charlesbaynham/GP22_RF_Photon_Correllation/PCB/BOM.xlsx

Refs | Value | Footprint | Quantity | MFR | MPN | SPR | SPN | Price Per component | Price Per board
R9;R7 | 100k | Resistors_SMD:R_0805_HandSoldering | 2 | - | - | - | - |  | 0
R8 | RS485_TERM | Resistors_ThroughHole:Resistor_Vertical_RM5mm | 1 | - | - | - | - |  | 0
R5;R6 | R | Resistors_SMD:R_0805_HandSoldering | 2 | - | - | - | - |  | 0
R38;R27;R26;R31;R30;R27;R26;R31;R30;R27;R26;R31;R30 | 10k | Resistors_SMD:R_0805_HandSoldering | 13 | - | - | - | - |  | 0
R35;R37 | 22R | Resistors_SMD:R_0805_HandSoldering | 2 | - | - | - | - |  | 0
R32;R33;R34;R29;R28;R29;R28;R29;R28 | 50R | Resistors_SMD:R_0805_HandSoldering | 9 | - | - | - | - |  | 0
R21;R22;R23;R3 | 100R | Resistors_SMD:R_0805_HandSoldering | 4 | - | - | - | - |  | 0
R20;R_Ser1;R_Ser2;R36 | 1k | Resistors_SMD:R_0805_HandSoldering | 4 | - | - | - | - |  | 0
R2;R1;R4 | 2M | Resistors_SMD:R_0805_HandSoldering | 3 | - | - | - | - |  | 0
C31;C29;C33;C34;C57;C24;C25;C26;C27;C20 | 100n | Capacitors_SMD:C_0805_HandSoldering | 10 | - | - | - | - |  | 0
C30;C32 | 8p | Capacitors_SMD:C_0805_HandSoldering | 2 | - | - | - | - |  | 0
C28;C4;C56;C18 | 1u | Capacitors_SMD:C_0805_HandSoldering | 4 | - | - | - | - |  | 0
C22 | 4u7 | Capacitors_SMD:C_0805_HandSoldering | 1 | - | - | - | - |  | 0
C21;C23 | 33u | Capacitors_SMD:C_0805_HandSoldering | 2 | - | - | - | - |  | 0
C19 | 10u | Capacitors_SMD:C_0805_HandSoldering | 1 | - | - | - | - |  | 0
C15;C16;C17 | 10p | Capacitors_SMD:C_0805_HandSoldering | 3 | - | - | - | - |  | 0
C12;C13;C14 | 10n | Capacitors_SMD:C_0805_HandSoldering | 3 | - | - | - | - |  | 0
C10;C11;C10;C11;C10;C11 | C_Small | Capacitors_SMD:C_0805_HandSoldering | 6 | - | - | - | - |  | 0
C1;C2;C5;C3 | C | Capacitors_SMD:C_0805_HandSoldering | 4 | - | - | - | - |  | 0
U2 | GP22 | Housings_DFN_QFN:QFN-32-1EP_5x5mm_Pitch0.5mm | 1 | ACAM | TDC-GP22 | Digikey | TDC-GP225KT&RCT-ND | 8.52 | 8.52
START1;STOP1;STOP2 | DP3T | Custom:ALPS_Rotary_SRBM | 3 | Apls Electric | SRBM131400 | RS | 123-9600 | 5.16 | 15.48
SCLK1;TX1;RX1;POWER1 | LED | LEDs:LED_0805 | 4 | Bivar | SM0805HC | RS | 174-9844 | 0.208 | 0.832
X1 | TSX-3225 X1E0000210013 | Crystals:crystal_FA238-TSX3225 | 1 | Epson | X1E000021001311 | RS | 667-6151 | 0.404 | 0.404
U12 | FT232RL | Housings_SSOP:SSOP-28_5.3x10.2mm_Pitch0.65mm | 1 | FTDI Chip | FT232RL | RS | 406-580 | 3.27 | 3.27
ICSP1 | HEADER | Pin_Headers:Pin_Header_Straight_2x03_Pitch2.54mm | 1 | Harwin | M20-9980346 | RS | 745-7046 | 0.2 | 0.2
U5 | IDT49FCT | Housings_SOIC:SOIC-20W_7.5x12.8mm_Pitch1.27mm | 1 | IDT | IDT49FCT3805ASOGI | RS | 715-4902 | 1.425 | 1.425
U3 | LTC6957-4 | Housings_SSOP:MSOP-12_3x4mm_Pitch0.65mm | 1 | Linear | LTC6957-4 | Digikey | LTC6957IMS-4#PBF-ND | 5.95 | 5.95
Y1 | 4MHz | Crystals:Crystal_HC49-4H_Vertical | 1 | Mercury | H49-4.000-18-30/50/4085 | RS | 672-0173 | 1.38 | 1.38
Y2 | 32.768 kHz | Crystals:Crystal_SMD_MicroCrystal_CC7V-T1A-2pin_3.2x1.5mm_HandSoldering | 1 | Micro Crystal | CM7V-T1A 32.768kHz 7pF +/-10ppm TA QC | RS | 729-3252 | 0.826 | 0.826
IC1 | ATMEGA328P-A | Housings_QFP:LQFP-32_7x7mm_Pitch0.8mm | 1 | Microchip Technology | ATMEGA328P-AN | RS | 131-0270 | 1.925 | 1.925
SineInput1;TTLInput1;STInput1;TTLOut1;TTLOut2;TTLOut3 | MMCX | Custom:MMCX_Socket | 6 | Molex | 73415-1001 | RS | 759-5300 | 3.97 | 23.82
P4 | USB_OTG | Custom:MICRO-B_USB_TOP_MOUNT | 1 | Molex | 47590-0001 | RS | 702-5481 | 0.502 | 0.502
U7 | MC74VHC1G04DTT1G | TO_SOT_Packages_SMD:SOT-353_SC-70-5_Handsoldering | 1 | ON Semiconductor | MC74VHC1G04DTT1G | RS | 806-3964 | 0.081 | 0.081
U1 | Right Angle | Backplane:96way_DIN_41612 | 1 | RS Pro | 252-210 | RS | 252-210 | 3.02 | 3.02
DISABLE_FLASH1;POWER_SEL1 | JMP | Pin_Headers:Pin_Header_Straight_1x03_Pitch2.54mm | 2 | RS Pro | 251-8092 | RS | 251-8092 | 0.093 | 0.186
U6 | LD1117S33TR | TO_SOT_Packages_SMD:SOT-223 | 1 | STMicroelectroncs | LD1117S33TR | RS | 168-6804 | 0.095 | 0.095
D7;D7;D7 | ESDA5V3SC6 | TO_SOT_Packages_SMD:SOT-23-5_HandSoldering | 3 | STMicroelectronics | ESDA5V3SC6 | RS | 250-000 | 0.357 | 1.071
CON1 | 5V power input | Connect:BARREL_JACK | 1 | Switchcraft | RAPC712X | Farnell | 1608726 | 1.56 | 1.56
FILT_SEL1;S+ DC/AC;S- DC/AC;S+ DC/AC;S- DC/AC;S+ DC/AC;S- DC/AC | HEADER | Pin_Headers:Pin_Header_Straight_2x02_Pitch2.54mm | 7 | TE Connectivity | 826632-2 | RS | 669-5288 | 0.335 | 2.345
U9 | SC74HC165N | Housings_DIP:DIP-16_W7.62mm_LongPads | 1 | TI | SN74HC165N | RS | 333-2978 | 0.308 | 0.308
U8 | SN74LV8154 | Housings_DIP:DIP-20_W7.62mm_LongPads | 1 | TI | SN74LV8154PW | RS | 663-2782 | 0.922 | 0.922
U4 | ISO3088 | Housings_SOIC:SOIC-16W_7.5x10.3mm_Pitch1.27mm | 1 | TI | ISO3088DW | RS | 121-9061 | 4.579 | 4.579
U11 | ISO7242 | Housings_SOIC:SOIC-16_7.5x10.3mm_Pitch1.27mm | 1 | TI | ISO7242CDW | RS | 121-9145 | 3.705 | 3.705
U10 | XC6206 | TO_SOT_Packages_SMD:SOT-23_Handsoldering | 1 | Torex | XC6206P332PR | Farnell | 8796998 | 0.483 | 0.483
 |  |  |  |  |  |  |  | Total component cost: | 82.889
 |  | Total component number: | 120 |  |  |  |  |  | 0
 |  | PCB Train Quotation (5 boards)
 |  | 5 day + 5 day
 |  | Manufacture | 312
 |  | Assembly | 920
 |  | Components | 83
 |  | Total | 1315
 |  | Total per board | 263
 |  | 10 day + 10 day
 |  | Manufacture | 231
 |  | Assembly | 613
 |  | Components | 83
 |  | Total | 927
 |  | Total per board | 185.4
