charlesbaynham/GP22_RF_Photon_Correllation/PCB/BOM_seanD_order.xlsx

Id | Refs | Number Required | Value | Footprint | Quantity per board | MFR | MPN | SPR | SPN | Customer Supplied? | Populate | Price Per component | Price Per board | For 8 boards | Ordered | Total | Received from Sean
1 | R9;R7 | 16 | 100k | Resistors_SMD:R_0805_HandSoldering | 2 | PCB Train free component stock | 0805-100K | - | - | FALSE | TRUE |  | £0.00 | 16 | 0 | £0.00 | FALSE
2 | R8 | 8 | - | Resistors_ThroughHole:Resistor_Vertical_RM5mm | 1 | - | - | - | - | FALSE | FALSE |  | £0.00 | 8 | 0 | £0.00 | FALSE
3 | R5 | 8 | 1M | Resistors_SMD:R_0805_HandSoldering | 1 | PCB Train free component stock | 0805-1M | - | - | FALSE | TRUE |  | £0.00 | 8 | 0 | £0.00 | FALSE
4 | R38;R27;R26;R31;R30;R27;R26;R31;R30;R27;R26;R31;R30 | 104 | 10k | Resistors_SMD:R_0805_HandSoldering | 13 | PCB Train free component stock | 0805-10K | - | - | FALSE | TRUE |  | £0.00 | 104 | 0 | £0.00 | FALSE
5 | R35;R37 | 16 | 22R | Resistors_SMD:R_0805_HandSoldering | 2 | PCB Train free component stock | 0805-22R | - | - | FALSE | TRUE |  | £0.00 | 16 | 0 | £0.00 | FALSE
6 | R32;R33;R34;R29;R28;R29;R28;R29;R28 | 72 | 50R | Resistors_SMD:R_0805_HandSoldering | 9 | PCB Train free component stock | 0805-51R | - | - | FALSE | TRUE |  | £0.00 | 72 | 0 | £0.00 | FALSE
7 | R21;R22;R23;R3 | 32 | 100R | Resistors_SMD:R_0805_HandSoldering | 4 | PCB Train free component stock | 0805-100R | - | - | FALSE | TRUE |  | £0.00 | 32 | 0 | £0.00 | FALSE
8 | R20;R_Ser1;R_Ser2;R36 | 32 | 1k | Resistors_SMD:R_0805_HandSoldering | 4 | PCB Train free component stock | 0805-1K | - | - | FALSE | TRUE |  | £0.00 | 32 | 0 | £0.00 | FALSE
9 | R2;R1;R4 | 24 | 2M | Resistors_SMD:R_0805_HandSoldering | 3 | PCB Train free component stock | 0805-2M | - | - | FALSE | TRUE |  | £0.00 | 24 | 0 | £0.00 | FALSE
10 | C31;C29;C33;C34;C57;C24;C25;C26;C27;C20 | 80 | 100n | Capacitors_SMD:C_0805_HandSoldering | 10 | PCB Train free component stock | 0805-100nF-50V | - | - | FALSE | TRUE |  | £0.00 | 80 | 0 | £0.00 | FALSE
11 | C30;C32 | 16 | 8p | Capacitors_SMD:C_0805_HandSoldering | 2 | AVX | 08055A8R2CAT2A | RS | 135-9011 | TRUE | TRUE | £0.07 | £0.14 | 16 | 100 | £7.20 | TRUE
12 | C28;C4;C56;C18 | 32 | 1u | Capacitors_SMD:C_0805_HandSoldering | 4 | PCB Train free component stock | 0805-1uF-50V | - | - | FALSE | TRUE |  | £0.00 | 32 | 0 | £0.00 | FALSE
13 | C22 | 8 | 4u7 | Capacitors_SMD:C_0805_HandSoldering | 1 | PCB Train free component stock | 0805-4.7uF-16V | - | - | FALSE | TRUE |  | £0.00 | 8 | 0 | £0.00 | FALSE
14 | C21;C23 | 16 | 33u | Capacitors_SMD:C_0805_HandSoldering | 2 | TDK | C2012X5R1A336M125AC | RS | 915-9274 | TRUE | TRUE | £0.96 | £1.91 | 16 | 20 | £19.12 | TRUE
15 | C19 | 8 | 10u | Capacitors_SMD:C_0805_HandSoldering | 1 | PCB Train free component stock | 0805-10uF-16V | - | - | FALSE | TRUE |  | £0.00 | 8 | 0 | £0.00 | FALSE
16 | C15;C16;C17 | 24 | x | Capacitors_SMD:C_0805_HandSoldering | 3 |  |  | - | - | FALSE | FALSE |  | £0.00 | 24 | 0 | £0.00 | FALSE
17 | C12;C13;C14 | 24 | 10n | Capacitors_SMD:C_0805_HandSoldering | 3 | PCB Train free component stock | 0805-10nF-50V | - | - | FALSE | TRUE |  | £0.00 | 24 | 0 | £0.00 | FALSE
18 | C6;C7;C8;C9;C10;C11 | 48 | 10n | Capacitors_SMD:C_0805_HandSoldering | 6 | PCB Train free component stock | 0805-10nF-50V | - | - | FALSE | TRUE |  | £0.00 | 48 | 0 | £0.00 | FALSE
19 | C1;C2;C5;C3 | 32 | 3.3p | Capacitors_SMD:C_0805_HandSoldering | 4 | PCB Train free component stock | 0805-3.3pF-50V | - | - | FALSE | TRUE |  | £0.00 | 32 | 0 | £0.00 | FALSE
20 | U2 | 8 | GP22 | Housings_DFN_QFN:QFN-32-1EP_5x5mm_Pitch0.5mm | 1 | ACAM | TDC-GP22 | Digikey | TDC-GP225KT&RCT-ND | TRUE | TRUE | £8.52 | £8.52 | 8 | 10 | £85.20 | TRUE
21 | START1;STOP1;STOP2 | 24 | DP3T | Custom:ALPS_Rotary_SRBM | 3 | Apls Electric | SRBM131400 | RS | 123-9600 | TRUE | TRUE | £5.16 | £15.48 | 24 | 24 | £123.84 | TRUE
22 | SCLK1;TX1;RX1;POWER1 | 32 | LED | LEDs:LED_0805 | 4 | Bivar | SM0805HC | RS | 174-9844 | TRUE | TRUE | £0.21 | £0.83 | 32 | 50 | £10.40 | TRUE
23 | X1 | 8 | TSX-3225 X1E0000210013 | Crystals:crystal_FA238-TSX3225 | 1 | Epson | X1E000021001311 | RS | 667-6151 | TRUE | TRUE | £0.40 | £0.40 | 8 | 10 | £4.04 | TRUE
24 | U12 | 8 | FT232RL | Housings_SSOP:SSOP-28_5.3x10.2mm_Pitch0.65mm | 1 | FTDI Chip | FT232RL | RS | 406-580 | TRUE | TRUE | £3.27 | £3.27 | 8 | 9 | £29.43 | TRUE
25 | ICSP1 | 8 | HEADER | Pin_Headers:Pin_Header_Straight_2x03_Pitch2.54mm | 1 | Harwin | M20-9980346 | RS | 745-7046 | TRUE | TRUE | £0.20 | £0.20 | 8 | 10 | £2.00 | TRUE
26 | U5 | 8 | IDT49FCT | Housings_SOIC:SOIC-20W_7.5x12.8mm_Pitch1.27mm | 1 | IDT | IDT49FCT3805ASOGI | RS | 715-4902 | TRUE | TRUE | £1.43 | £1.43 | 8 | 10 | £14.25 | TRUE
27 | U3 | 8 | LTC6957-4 | Housings_SSOP:MSOP-12_3x4mm_Pitch0.65mm | 1 | Linear | LTC6957-4 | Digikey | LTC6957IMS-4#PBF-ND | TRUE | TRUE | £5.95 | £5.95 | 8 | 10 | £59.50 | TRUE
28 | Y1 | 8 | 4MHz | Crystals:Crystal_HC49-4H_Vertical | 1 | Mercury | H49-4.000-18-30/50/4085 | RS | 672-0173 | TRUE | TRUE | £1.38 | £1.38 | 8 | 10 | £13.80 | TRUE
29 | Y2 | 8 | 32.768 kHz | Crystals:Crystal_SMD_MicroCrystal_CC7V-T1A-2pin_3.2x1.5mm_HandSoldering | 1 | Micro Crystal | CM7V-T1A 32.768kHz 7pF +/-10ppm TA QC | RS | 729-3252 | TRUE | TRUE | £0.83 | £0.83 | 8 | 10 | £8.26 | TRUE
30 | IC1 | 8 | ATMEGA328P-A | Housings_QFP:LQFP-32_7x7mm_Pitch0.8mm | 1 | Microchip Technology | ATMEGA328P-AN | RS | 131-0270 | TRUE | TRUE | £1.93 | £1.93 | 8 | 10 | £19.25 | TRUE
31 | SineInput1;TTLInput1;STInput1;TTLOut1;TTLOut2;TTLOut3 | 48 | MMCX | Custom:MMCX_Socket | 6 | Molex | 73415-1001 | RS | 759-5300 | TRUE | TRUE | £3.97 | £23.82 | 48 | 50 | £198.50 | TRUE
32 | P4 | 8 | USB_OTG | Custom:MICRO-B_USB_TOP_MOUNT | 1 | Molex | 47590-0001 | RS | 702-5481 | TRUE | TRUE | £0.50 | £0.50 | 8 | 10 | £5.02 | TRUE
33 | U7 | 8 | MC74VHC1G04DTT1G | TO_SOT_Packages_SMD:SOT-353_SC-70-5_Handsoldering | 1 | ON Semiconductor | MC74VHC1G04DTT1G | RS | 806-3964 | TRUE | TRUE | £0.08 | £0.08 | 8 | 100 | £8.10 | TRUE
34 | U1 | 8 | Right Angle | Backplane:96way_DIN_41612 | 1 | RS Pro | 252-210 | RS | 252-210 | TRUE | TRUE | £3.02 | £3.02 | 8 | 8 | £24.16 | TRUE
35 | DISABLE_FLASH1;POWER_SEL1 | 16 | JMP | Pin_Headers:Pin_Header_Straight_1x03_Pitch2.54mm | 2 | RS Pro | 251-8092 | RS | 251-8092 | TRUE | TRUE | £0.09 | £0.19 | 16 | 25 | £2.33 | TRUE
36 | U6 | 8 | LD1117S33TR | TO_SOT_Packages_SMD:SOT-223 | 1 | STMicroelectroncs | LD1117S33TR | RS | 714-0697 | TRUE | TRUE | £0.10 | £0.10 | 8 | 10 | £0.95 | TRUE
37 | D7;D7;D7 | 24 | ESDA5V3SC6 | TO_SOT_Packages_SMD:SOT-23-5_HandSoldering | 3 | STMicroelectronics | ESDA5V3SC6 | RS | 250-000 | TRUE | TRUE | £0.36 | £1.07 | 24 | 40 | £14.28 | TRUE
38 | CON1 | 8 | 5V power input | Connect:BARREL_JACK | 1 | Switchcraft | RAPC712X | Farnell | 1608726 | TRUE | TRUE | £1.56 | £1.56 | 8 | 10 | £15.60 | TRUE
39 | FILT_SEL1;S+ DC/AC;S- DC/AC;S+ DC/AC;S- DC/AC;S+ DC/AC;S- DC/AC | 56 | HEADER | Pin_Headers:Pin_Header_Straight_2x02_Pitch2.54mm | 7 | TE Connectivity | 826632-2 | RS | 669-5288 | TRUE | TRUE | £0.34 | £2.35 | 56 | 60 | £20.10 | TRUE
40 | U9 | 8 | SC74HC165N | Housings_DIP:DIP-16_W7.62mm_LongPads | 1 | TI | SN74HC165N | RS | 333-2978 | TRUE | TRUE | £0.31 | £0.31 | 8 | 25 | £7.70 | TRUE
41 | U8 | 8 | SN74LV8154 | Housings_DIP:DIP-20_W7.62mm_LongPads | 1 | TI | SN74LV8154PW | RS | 663-2782 | TRUE | TRUE | £0.92 | £0.92 | 8 | 10 | £9.22 | TRUE
42 | U4 | 8 | ISO3088 | Housings_SOIC:SOIC-16W_7.5x10.3mm_Pitch1.27mm | 1 | TI | ISO3088DW | RS | 660-7660 | TRUE | TRUE | £4.58 | £4.58 | 8 | 9 | £41.21 | TRUE
43 | U11 | 8 | ISO7242 | Housings_SOIC:SOIC-16_7.5x10.3mm_Pitch1.27mm | 1 | TI | ISO7242CDW | RS | 661-3447 | TRUE | TRUE | £3.71 | £3.71 | 8 | 9 | £33.34 | TRUE
44 | U10 | 8 | XC6206 | TO_SOT_Packages_SMD:SOT-23_Handsoldering | 1 | Torex | XC6206P332PR | Farnell | 8796998 | TRUE | TRUE | £0.48 | £0.48 | 8 | 10 | £4.83 | TRUE
45 | R6 | 8 | - | Resistors_SMD:R_0805_HandSoldering | 1 | - | - |  |  | FALSE | FALSE |  | £0.00 | 8 |  | £0.00 | FALSE
Total |  |  |  |  |  |  |  |  |  |  |  |  | £84.94 |  |  | £781.63 | 0
 |  |  | PCB Train Quotation (8 boards)
 |  |  | 5 day + 5 day
 |  |  | Manufacture | £419.15
 |  |  | Assembly | £1287.00
 |  |  | Components | £781.63
 |  |  | Total | £2487.78
 |  |  | Total per board | £310.97
 |  |  |  |  |  | 554
 |  |  |  |  |  | 419.15
