charlesbaynham/GP22_RF_Photon_Correllation/PCB/Rack mounting/GP22_Panel_HP14.SLDPRT

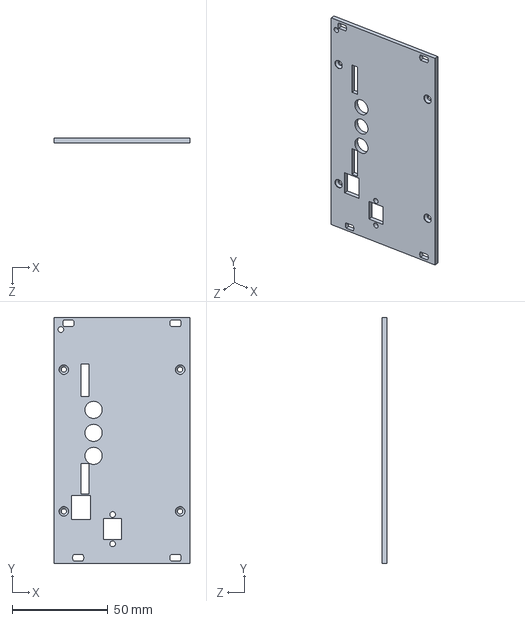
[picture p1: CAD file, 2019-10-17]
PCB/Rack mounting/GP22_Panel_HP14.SLDPRT
70.8 x 128.4 x 2.50 mm
