charlesbaynham/GP22_RF_Photon_Correllation/PCB/Rack mounting/GP22_Panel_HP12.STL

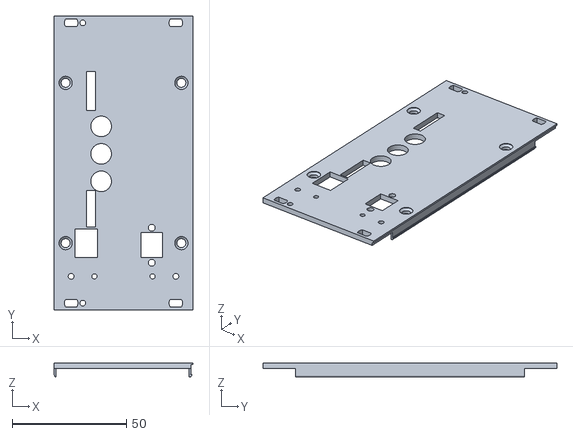
[picture p2: CAD file, 2019-10-17]
PCB/Rack mounting/GP22_Panel_HP12.STL
60.6 x 128.4 x 6.20
