charlesbaynham/GP22_RF_Photon_Correllation/(list of files, cad)

Other CAD files:
PCB/Rack mounting/GP22_Panel_HP14.STL
