charlesbaynham/GP22_RF_Photon_Correllation/PCB/GP22_board.kicad_pcb

## KiCad design PCB/GP22_board.kicad_pcb (2018-09-26)

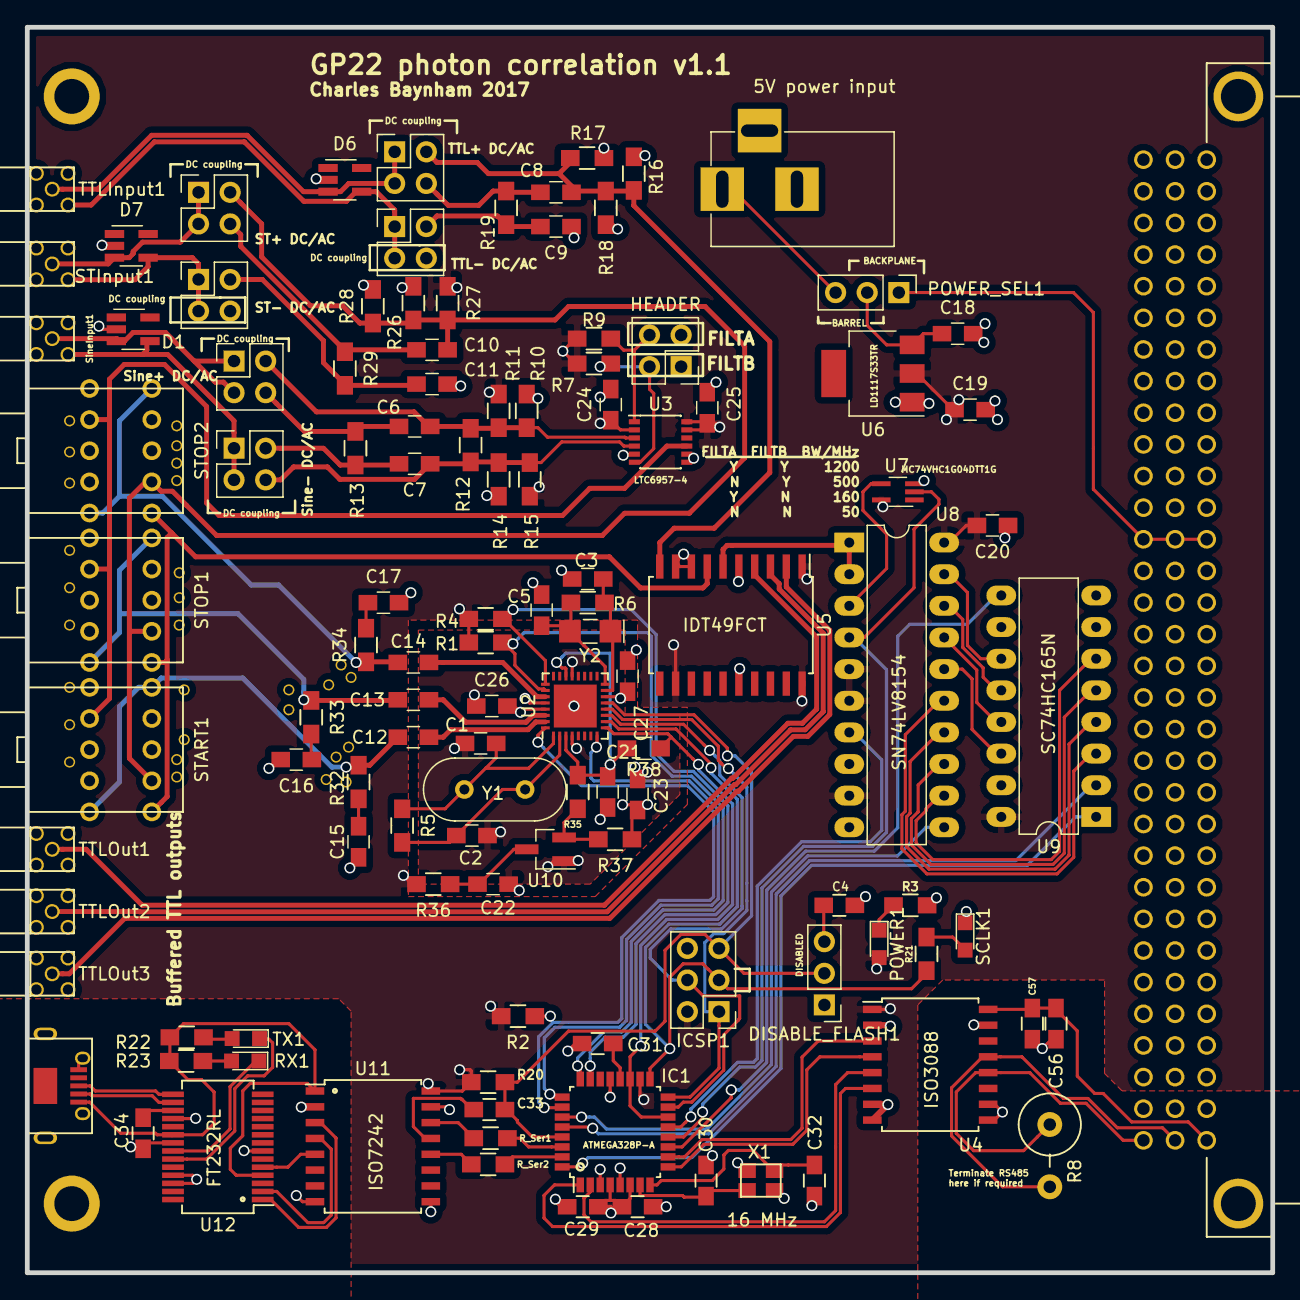
[picture p11: board GP22_board.kicad_pcb from above]

Board: 4 copper layers, 100.0 x 100.0 mm, 145 parts (0 on the bottom side), 108 nets.

Parts:
C1, C2, C3, C5: 3p3; C_0805_HandSoldering
C4, C18, C28, C56: 1u; C_0805_HandSoldering
C6, C7, C8, C9, C10, C11: C_Small; C_0805_HandSoldering
C12, C13, C14: 10n; C_0805_HandSoldering
C15, C16, C17: x; C_0805_HandSoldering
C19: 10u; C_0805_HandSoldering
C20, C24, C25, C26, C27, C29, C31, C33, C34, C57: 100n; C_0805_HandSoldering
C21, C23: 33u; C_0805_HandSoldering
C22: 4u7; C_0805_HandSoldering
C30, C32: 8p; C_0805_HandSoldering
CON1: 5V power input; BARREL_JACK
D1, D6, D7: ESDA5V3SC6; SOT-23-5_HandSoldering
DISABLE_FLASH1: JMP; Pin_Header_Straight_1x03_Pitch2.54mm
FILT_SEL1: HEADER; Pin_Header_Straight_2x02_Pitch2.54mm
IC1: ATMEGA328P-A; LQFP-32_7x7mm_Pitch0.8mm
ICSP1: HEADER; Pin_Header_Straight_2x03_Pitch2.54mm
P4: USB_OTG; MICRO-B_USB_TOP_MOUNT
P7, P8, P9, P10, P11, P12: HEADER; Pin_Header_Straight_2x02_Pitch2.54mm
POWER1: LED; LED_0805
POWER_SEL1: JMP; Pin_Header_Straight_1x03_Pitch2.54mm
R1, R2, R4: 2M; R_0805_HandSoldering
R3, R21, R22, R23: 100R; R_0805_HandSoldering
R5: 1M; R_0805_HandSoldering
R6: x; R_0805_HandSoldering
R7, R9: 100k; R_0805_HandSoldering
R8: RS485_TERM; Resistor_Vertical_RM5mm
R10, R11, R14, R15, R16, R17, R26, R27, R38: 10k; R_0805_HandSoldering
R12, R13, R18, R19, R28, R29, R32, R33, R34: 50R; R_0805_HandSoldering
R20, R36: 1k; R_0805_HandSoldering
R35, R37: 22R; R_0805_HandSoldering
RX1: LED; LED_0805
R_Ser1, R_Ser2: 1k; R_0805_HandSoldering
SCLK1: LED; LED_0805
START1: DP3T; ALPS_Rotary_SRBM
STInput1: MMCX; MMCX_Socket
STOP1, STOP2: DP3T; ALPS_Rotary_SRBM
SineInput1: MMCX; MMCX_Socket
TTLInput1: MMCX; MMCX_Socket
TTLOut1, TTLOut2, TTLOut3: MMCX; MMCX_Socket
TX1: LED; LED_0805
U1: Right Angle; 96way_DIN_41612
U2: GP22; QFN-32-1EP_5x5mm_Pitch0.5mm
U3: LTC6957-4; MSOP-12_3x4mm_Pitch0.65mm
U4: ISO3088; SOIC-16W_7.5x10.3mm_Pitch1.27mm
U5: IDT49FCT; SOIC-20W_7.5x12.8mm_Pitch1.27mm
U6: LD1117S33TR; SOT-223
U7: MC74VHC1G04DTT1G; SOT-353_SC-70-5_Handsoldering
U8: SN74LV8154; DIP-20_W7.62mm_LongPads
U9: SC74HC165N; DIP-16_W7.62mm_LongPads
U10: XC6206; SOT-23_Handsoldering
U11: ISO7242; SOIC-16_7.5x10.3mm_Pitch1.27mm
U12: FT232RL; SSOP-28_5.3x10.2mm_Pitch0.65mm
VIA**: ViaHack
VIA**#2, VIA**#3, VIA**#4, VIA**#5, VIA**#6, VIA**#7, VIA**#8, VIA**#9, VIA**#10, VIA**#11, VIA**#12, VIA**#13, VIA**#14, VIA**#15, VIA**#16, VIA**#17, VIA**#18, VIA**#19, VIA**#20, VIA**#21, VIA**#22, VIA**#23, VIA**#24, VIA**#25, VIA**#26, VIA**#27, VIA**#28, VIA**#29: ViaHack
X1: TSX-3225 X1E0000210013; crystal_FA238-TSX3225
Y1: 4MHz; Crystal_HC49-4H_Vertical
Y2: 32.768 kHz; Crystal_SMD_MicroCrystal_CC7V-T1A-2pin_3.2x1.5mm_HandSolder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

Connections:
+3V3: C19.1, C20.2, C24.1, C25.1, C28.1, C29.1, IC1.4, IC1.6, IC1.18, ICSP1.2, POWER1.2, R1.1, R2.2, R4.1, R7.2, R9.1, R11.1, R15.2, R17.1, R20.1, R27.1, R36.2, U3.2, U3.11, U3.12, U4.1, U5.1, U5.12, U5.20, U6.2, U7.5, U8.5, U8.6, U8.9, U8.20, U9.16, U11.16
/ARD_RST: C33.1, DISABLE_FLASH1.2, IC1.29, ICSP1.5, R20.2, U2.13
/BPSubsheet/+3.3V: U1.A15, U1.B15, U1.C15
/BPSubsheet/+12V: U1.A9, U1.B9, U1.C9
/BPSubsheet/+15V: U1.A5, U1.B5, U1.C5
/BPSubsheet/+24V: U1.A1, U1.B1, U1.C1
/BPSubsheet/-5V: U1.A11, U1.B11, U1.C11
/BPSubsheet/-12V: U1.A7, U1.B7, U1.C7
/BPSubsheet/-15V: U1.A3, U1.B3, U1.C3
/Backplane_5V: POWER_SEL1.1, U1.A13, U1.B13, U1.C13
/CTR_BIT_SEL: IC1.12, U7.2, U8.4
/CTR_LOAD: IC1.13, U8.7
/Counter/~CTR_GAL: U7.4, U8.3
/DIYino/D0/RX: IC1.30, R_Ser1.1
/DIYino/D1/TX: IC1.31, R_Ser2.2
/DIYino/RX: R_Ser1.2, U11.14
/DIYino/TX: R_Ser2.1, U11.12
/DIYino/USB_3V3: C34.1, U12.17
/DIYino/USB_5V: P4.1, R22.2, R23.2, U11.1, U12.4, U12.20
/DIYino/USB_D+: P4.3, U12.15
/DIYino/USB_D-: P4.2, U12.16
/DIYino/USB_GND: C34.2, P4.5, P4.6, U11.2, U11.8, U12.7, U12.18, U12.21, U12.25, U12.26
/DIYino/USB_RESET_IN: U11.4, U12.2
/DIYino/USB_RESET_OUT: C33.2, U11.13
/G1: C12.2, U2.31
/G2: C13.2, U2.30
/G3: C14.2, U2.27
/GP22_CS: IC1.14, IC1.19, R38.1, U2.9
/GP22_EN_START: IC1.26, R2.1, U2.32
/GP22_EN_STOP1: IC1.24, R1.2, U2.26
/GP22_EN_STOP2: IC1.23, R4.2, U2.25
/GP22_INT: IC1.25, U2.8
/GP22_MISO: IC1.16, ICSP1.1, U2.12
/GP22_MOSI: IC1.15, ICSP1.4, U2.11
/GP22_SCK: IC1.17, ICSP1.3, R21.1, U2.10
/GP22_START: C12.1, R32.1, START1.1a, START1.5b
/GP22_STOP1: C13.1, R33.1, STOP1.1a, STOP1.5b
/GP22_STOP2: C14.1, R34.1, STOP2.1a, STOP2.5b
/GP22_VCC: C23.1, C26.2, C27.2, R37.1, U2.14, U2.29
/GP22_VIO: C21.1, R35.1, R38.2, U2.3, U2.22
/InputCoupling2/InputGnd: D6.4, P10.1, P10.3, TTLInput1.2
/InputCoupling2/InputSignal: D6.3, P9.1, P9.3, TTLInput1.1
/InputCoupling2/OutputS+: C8.2, P9.2, R16.1, R17.2, R18.1, U5.10
/InputCoupling2/RF_2: C8.1, P9.4, R19.1
/InputCoupling2/RF_4: C9.2, P10.2, R19.2
/InputCoupling3/InputGnd: D7.4, P12.1, P12.3, STInput1.2
/InputCoupling3/InputSignal: D7.3, P11.1, P11.3, STInput1.1
/InputCoupling3/RF_2: C10.1, P11.4, R29.1
/InputCoupling3/RF_4: C11.2, P12.2, R29.2
/InputCoupling/InputGnd: D1.4, P8.1, P8.3, SineInput1.2
/InputCoupling/InputSignal: D1.3, P7.1, P7.3, SineInput1.1
/InputCoupling/OutputS+: C6.2, P7.2, R10.1, R11.2, R12.1, U3.3
/InputCoupling/OutputS-: C7.1, P8.4, R12.2, R14.2, R15.1, U3.4
/InputCoupling/RF_2: C6.1, P7.4, R13.1
/InputCoupling/RF_4: C7.2, P8.2, R13.2
/REG_CLK: IC1.28, U9.2
/REG_DATA: IC1.11, U9.9
/REG_LOAD: IC1.32, U9.1
/RS485_+5V: C56.1, C57.1, U1.C32, U4.16
/RS485_A: R8.1, U1.A32, U4.12
/RS485_B: R8.2, U1.B32, U4.13
/RS485_D: IC1.1, U4.6
/RS485_DE: IC1.2, U4.5
/RS485_GND: C56.2, C57.2, U1.A31, U1.B31, U1.C31, U4.9, U4.10, U4.15
/RS485_R: IC1.10, U4.3
/RS485_RE: IC1.9, U4.4
/SineRectified: START1.4a, STOP1.4a, STOP2.4a, U3.9
/StraightThrough: C10.2, P11.2, R26.1, R27.2, R28.1, START1.2b, STOP1.2b, STOP2.2b
/TTLBuffered: START1.1b, STOP1.1b, STOP2.1b, U5.7
/TTLBufferedOut1: TTLOut1.1, U5.4
/TTLBufferedOut2: TTLOut2.1, U5.3
/TTLBufferedOut3: TTLOut3.1, U5.2
/TTLBufferedOut_toCounter: U5.6, U8.1, U8.2
/~CTR_CLR: IC1.27, U8.11
GND: C1.1, C2.1, C3.2, C4.2, C5.2, C9.1, C11.1, C15.2, C16.2, C17.2, C18.2, C19.2, C20.1, C21.2, C22.2, C23.2, C24.2, C25.2, C26.1, C27.1, C28.2, C29.2, C30.1, C31.2, C32.2, CON1.2, CON1.3, D1.2, D6.2, D7.2, FILT_SEL1.1, FILT_SEL1.3, IC1.3, IC1.5, IC1.21, ICSP1.6, P10.4, P12.4, R3.2, R10.2, R14.1, R16.2, R18.2, R26.2, R28.2, SCLK1.1, TTLOut1.2, TTLOut2.2, TTLOut3.2, U1.A2, U1.A4, U1.A6, U1.A8, U1.A10, U1.A12, U1.A14, U1.A16, U1.B2, U1.B4, U1.B6, U1.B8, U1.B10, U1.B12, U1.B14, U1.B16, U1.C2, U1.C4, U1.C6, U1.C8, U1.C10, U1.C12, U1.C14, U1.C16, U2.4, U2.21, U2.28, U2.33, U3.5, U3.7, U3.8, U4.2, U4.7, U4.8, U5.5, U5.8, U5.9, U5.16, U6.1, U7.3, U8.10, U9.8, U9.10, U9.15, U10.1, U11.9, U11.15, VIA**.1, VIA**#2.1, VIA**#3.1, VIA**#4.1, VIA**#5.1, VIA**#6.1, VIA**#7.1, VIA**#8.1, VIA**#9.1, VIA**#10.1, VIA**#11.1, VIA**#12.1, VIA**#13.1, VIA**#14.1, VIA**#15.1, VIA**#16.1, VIA**#17.1, VIA**#18.1, VIA**#19.1, VIA**#20.1, VIA**#21.1, VIA**#22.1, VIA**#23.1, VIA**#24.1, VIA**#25.1, VIA**#26.1, VIA**#27.1, VIA**#28.1, VIA**#29.1, X1.3
unnamed: C1.2, R5.1, U2.1, Y1.2
unnamed: C2.2, R5.2, U2.2, Y1.1
unnamed: C3.1, R6.2, U2.15, Y2.1
unnamed: C4.1, DISABLE_FLASH1.3
unnamed: C5.1, R6.1, U2.16, Y2.2
unnamed: C15.1, R32.2
unnamed: C16.1, R33.2
unnamed: C17.1, R34.2
unnamed: C18.1, POWER_SEL1.2, U6.3
unnamed: C22.1, R36.1, U10.3
unnamed: C30.2, IC1.7, X1.1
unnamed: C31.1, IC1.20
unnamed: C32.1, IC1.8, X1.2
unnamed: CON1.1, POWER_SEL1.3
unnamed: FILT_SEL1.2, R7.1, U3.6
unnamed: FILT_SEL1.4, R9.2, U3.1
unnamed: POWER1.1, R3.1
unnamed: R21.2, SCLK1.2
unnamed: R22.1, TX1.2
unnamed: R23.1, RX1.2
unnamed: R35.2, R37.2, U10.2
unnamed: RX1.1, U12.22
unnamed: TX1.1, U12.23
unnamed: U8.12, U9.6
unnamed: U8.13, U9.5
unnamed: U8.14, U9.4
unnamed: U8.15, U9.3
unnamed: U8.16, U9.14
unnamed: U8.17, U9.13
unnamed: U8.18, U9.12
unnamed: U8.19, U9.11
unnamed: U11.3, U12.1
unnamed: U11.5, U12.5
