charlesbaynham/GP22_RF_Photon_Correllation/TDC_Arduino_Driver/CommandHandler/examples/BasicUsage/BasicUsage.ino

#include <CommandHandler.h>

// Create a CommandHandler object to hold 5 commands
CommandHandler<5> h;


///////////////////////////////////////////////////////
// Declare functions to be called by serial commands //
///////////////////////////////////////////////////////

commandFunction helloWorld; // "hello"
commandFunction helloWorldQ; // "hello?"
commandFunction echoMe; // "echo"
commandFunction adder; // "add"
commandFunction echoMany; // "echoMany"

///////////////////////////////////////////////////////
//             End function declaration              //
///////////////////////////////////////////////////////


void setup() {

  Serial.begin(57600);
  Serial.println(F("Program started..."));

	// Register serial commands for triggering the previously
	// declared functions

	// Commands are case insensitive. Here we choose a serial command, the number of
	// parameters it takes (to be read as strings, delimited by spaces) and the
	// function it links to

	h.registerCommand(COMMANDHANDLER_HASH( "heLLo" ), 0, helloWorld);
	h.registerCommand(COMMANDHANDLER_HASH( "hello?"), 0, helloWorldQ);
	h.registerCommand(COMMANDHANDLER_HASH( "eCHo"), 1, echoMe);
	h.registerCommand(COMMANDHANDLER_HASH( "add"), 2, adder);

	// Setting num params to "-1" will allow any number of params to be passed
	h.registerCommand(COMMANDHANDLER_HASH( "echoMany"), -1, echoMany);
}

void loop() {

	// Check for commands
	if (h.commandWaiting()) {

		// Execute first waiting command
		CommandHandlerReturn result = h.executeCommand();

		// Report any errors
		switch (result) {
		case CommandHandlerReturn::COMMAND_NOT_FOUND:

			Serial.println(F("Command not found"));
			break;

		case CommandHandlerReturn::WRONG_NUM_OF_PARAMS:

			Serial.println(F("Wrong number of params"));
			break;

		default:

			Serial.print(F("Error code "));
			Serial.println(int(result));

		}
	}

	// Check for serial input
	while (Serial.available()) {
		// Queue input for processing
		h.addCommandChar(Serial.read());
	}
}

///////////////////////////////////////////////////////
//                 Define functions                  //
///////////////////////////////////////////////////////

// Takes no params
void helloWorld(const ParameterLookup& params) {

	Serial.println(F("Hello world!"));

}

// Takes no params
void helloWorldQ(const ParameterLookup& params) {

	Serial.println(F("You sent a SCPI query"));
}

// Echo a string
// 1 param
void echoMe(const ParameterLookup& params) {

	Serial.print(F("Passed string was: \""));
	Serial.print(params[1]);
	Serial.print(F("\", command was: "));
	Serial.println(params[0]);
}

// Add two numbers
// 2 params
void adder(const ParameterLookup& params) {

	// Convert the first parameter to a number
	double first = atof(params[1]);

	// And the second
	double second = atof(params[2]);

	// Add and output
	Serial.print(F("Sum of "));
	Serial.print(first);
	Serial.print(F(" and "));
	Serial.print(second);
	Serial.print(F(" is "));
	Serial.println(first + second);
}

// Echo unlimited number of parameters
// unlimited paramas
void echoMany(const ParameterLookup& params) {

	Serial.print(F("Number of params to echo is: "));
	Serial.println(params.size());

	// Loop until list is done
	for (int i = 0; i < params.size(); i++) {
		Serial.print('"');
		Serial.print(params[i]);
		Serial.println('"');
	}
}
