charlesbaynham/GP22_RF_Photon_Correllation/TDC_Arduino_Driver/latest_hash.h

/* This file is automatically overwritten by git 
 * whenever a commit or checkout is completed. 
 * 
 * If you can see this comment, you must copy the files "post-checkout"
 * and "post-commit" into the .git/hooks folder */

#define LATEST_HASH "???????"
