charlesbaynham/GP22_RF_Photon_Correllation/(commit log)

2015-02-25 Rewrite into driver
2015-02-26 README. Add note to ensure that DELVAL1 is set to zero before you attempt measurements, thus avoiding many hours of debugging
    [TDC_Arduino_Driver.ino]
2015-02-26 Do EEPROM load in the arduino init rather than before each measurement
2015-03-12 Calibration routine for measurement mode 1
2015-03-12 Clarify the output of the calibration routine
2015-03-13 Add Calibrate method and prepare for split metweeb measurement mode 1 & 2
2015-03-13 Make arduino aware of which mode it's in and report data accordingly (16 bits or 32 bits depending on calibration settings)
2015-03-13 Arduino report timeouts properly in non-calibrated mode
2015-03-13 Labview interface to setup defaults, read uncalibrated data and test for the calibration wobble
2015-03-16 More informative errors and comments
    [TDC_Arduino_Driver.ino]
2015-03-16 Use the ACAM sequence for calibration but read the pointer from STATUS N.B. These calibration measurements seem to loop very predictably. I think this is the TDC, not my code
2015-03-16 Check status before reading calibration
2015-03-16 Go into MM2 and use quad resolution for the calibration
2015-03-16 Labview stuff: Default mode is now double resolution, measurements take account of this. Calibration is done in quad mode and stored for single mode.
2015-03-17 Move the init for calibration to before the calculation requests since the START_TDC_CAL actually produces hits. Also update Labview to reflect corrected calibration.
    [TDC_Arduino_Driver.ino]
2015-03-17 Fix odd ordering of calibration in single measurement
2015-03-20 Store all registers on the arduino
2015-03-20 Add function for high speed clock calibration
2015-03-20 Labview: High freq calibration method
2015-03-20 Integrate calibrated clock into all VIs
2015-03-20 Calibrate the HF clock on startup
2015-03-20 Add calibration to the state machine
2015-03-20 Add configuration options for double precision / auto-calibrate
2015-03-31 Adapt for new breakout board
2015-05-07 Add VI to return multiple measurements, taking care of calibration itself
2016-05-13 Basic MWE of error
    [TDC_Arduino_Driver.ino]
2016-05-23 Fix memory leak
    Fix memory leak, check for too long commands better. Also improve
    debugging by adding macros and more useful messages
    [CommandHandler.h]
2016-05-23 Found and fixed the problem!
    [TDC_Arduino_Driver.ino]
2016-05-23 STILL a mem leak!
    [TDC_Arduino_Driver.ino]
2016-05-23 Found a really silly mem leak
    [TDC_Arduino_Driver.ino]
2016-05-24 Avoid copying Lists by using const references where possible
    [TDC_Arduino_Driver.ino]
2016-07-01 Correctly detect start and end of commands
    [CommandHandler.h]
2016-07-05 Structure for new stack based commandHandler (not working yet)
    [CommandHandler.h]
2016-07-05 Fix newly broken EEPROM functionality
    [CommandHandler.h]
2016-07-07 BUG: Check for Serial comms before outputting
    [CommandHandler.h]
2016-07-11 Bug in setting registers
    [TDC_Arduino_Driver.ino]
2016-07-13 Set default TDC settings to ACAM's settings from their VI. Update Labview to use new commands.
    These settings produce output, but the conversion is wrong: we're assuming LSBs but actually reading converted floats
    [TDC_Arduino_Driver.ino]
2016-07-28 BUGFIX: ssending register settings failed if the first bit was high
    [TDC_Arduino_Driver.ino]
2016-10-21 Be a bit less memory hungry:
    Avoid Strings and don't request MAX_COMMAND_SIZE buffers from the stack other than the preassigned one
    [CommandHandler.h]
2016-11-03 Fix annoying typecasting problem
    [GP22_reg.h]
2017-01-31 NPL Backplane template initial commit
    [BPSubsheet.sch, DIYino.sch, GP22_board.kicad_pcb, GP22_board.sch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]
2017-01-31 Add GP22 schematic
2017-02-03 Add components to library
    [BPSubsheet.sch, DIYino.sch, GP22_board.sch]
2017-02-03 Inputs designed
    [BPSubsheet.sch, DIYino.sch, GP22_board.sch, InputCoupling.sch]
2017-02-09 Nearly finish schematic, add counter, coupling options
    [BPSubsheet.sch, Counter.sch, DIYino.sch, GP22_board.sch, InputCoupling.sch, SignalSelection.sch]
2017-02-09 Complete (?) schematic, footprints and component selection
    [BPSubsheet.sch, Counter.sch, DIYino.sch, GP22_Power.sch, GP22_board.sch, InputCoupling.sch, SignalSelection.sch]
2017-02-09 Use MCXX sockets instead of SMA because otherwise it won't all fit!
    [GP22_board.sch, InputCoupling.sch]
2017-02-09 Route the signals! And replace the diodes
    [BPSubsheet.sch, Counter.sch, DIYino.sch, GP22_Power.sch, GP22_board.sch, InputCoupling.sch, SignalSelection.sch]
2017-02-09 Board nearly done
    [Counter.sch, GP22_Power.sch, GP22_board.kicad_pcb, GP22_board.sch, InputCoupling.sch, SignalSelection.sch]
2017-02-10 Take 5V from backplane instead of 3V3: regulate it on-board
    [BPSubsheet.sch, Counter.sch, DIYino.sch, GP22_Power.sch, GP22_board.sch, InputCoupling.sch, SignalSelection.sch]
2017-02-10 DRC passes
    [BPSubsheet.sch, Counter.sch, DIYino.sch, GP22_Power.sch, GP22_board.kicad_pcb, GP22_board.sch, InputCoupling.sch, SignalSelection.sch]
2017-02-10 Silkscreen labelling
    [GP22_board.kicad_pcb, InputCoupling.sch]
2017-02-10 Tweaks to RF path
    [BPSubsheet.sch, Counter.sch, DIYino.sch, GP22_Power.sch, GP22_board.kicad_pcb, GP22_board.sch, InputCoupling.sch, SignalSelection.sch]
2017-02-10 Flood the top and bottom
    [GP22_board.kicad_pcb]
2017-02-10 Swap plane order and route power by bottom pour, for EMC and ground-inductance considerations
    [GP22_board.kicad_pcb, GP22_board.sch]
2017-02-10 Add soldermask to via hack, label board, gerbers
    [GP22_board-B.Cu.gbl, GP22_board-B.Mask.gbs, GP22_board-B.Paste.gbp, GP22_board-B.SilkS.gbo, GP22_board-Edge.Cuts.gm1, GP22_board-F.Cu.gtl, GP22_board-F.Mask.gts, GP22_board-F.Paste.gtp]
2017-02-20 BOM added
    [BOM.xlsx]
2017-03-01 Timeout warning for calibration
2017-03-01 Bug fix: CS for TDC was floating to undefined level when MC was not flashed, causing SPI pollution
    Added a 10k pullup resistor to CS to fix this
    [GP22_board-B.Cu.gbl, GP22_board-B.Mask.gbs, GP22_board-B.Paste.gbp, GP22_board-B.SilkS.gbo, GP22_board-Edge.Cuts.gm1, GP22_board-F.Cu.gtl, GP22_board-F.Mask.gts, GP22_board-F.Paste.gtp]
2017-03-13 Add Solidworks frontpanel
    [Panel-recognised.SLDPRT]
2017-03-13 Save changes to panel and output as STL
    [GP22_Panel.SLDPRT, GP22_Panel.STL]
2017-03-13 Remove old named panel
    [Panel-recognised.SLDPRT]
2017-03-21 Correct stack overflow error and report command_roo_long errors
    [CommandHandler.h]
2017-07-20 Speed up SPI comms
2017-07-20 Multiple measurement mode listens to calibration, device starts at defaults + double res, mode 1
2018-06-28 Update sch for new kicad version
    [BPSubsheet.sch, Counter.sch, DIYino.sch, GP22_Power.sch, GP22_board.sch, InputCoupling.sch]
2018-06-28 Ground crystal case
    [Counter.sch, DIYino.sch]
2018-06-28 Correct input coupling orientation
    [BPSubsheet.sch, Counter.sch, DIYino.sch, GP22_Power.sch, InputCoupling.sch]
2018-06-28 Correct pin headers to odd-even
    [DIYino.sch, GP22_board.sch, InputCoupling.sch]
2018-06-28 Record the part number of the rotary switch
2018-06-28 Fix the Rotary switch schematic file
    [GP22_board.sch]
2018-06-28 Create netlist and update board: no changes except to crystal grounding
    [GP22_board.kicad_pcb]
2018-08-08 Fix Rotary switch footprint (NEVER TRUST KICAD FOOTPRINTS!!!)
    [GP22_board.kicad_pcb]
2018-08-08 Produce BOM with "Boms away"
    [BOM.csv, BOM.xlsx, BPSubsheet.sch, Counter.sch, DIYino.sch, GP22_Power.sch, GP22_board.kicad_pcb, GP22_board.sch]
2018-08-08 Labelling tweaks
    [GP22_board.kicad_pcb]
2018-08-08 Output gerbers
    [BOM.csv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]
2018-08-09 BOM corrections (thanks Sean!)
    [BOM.xlsx, DIYino.sch, GP22_board.sch, InputCoupling.sch]
2018-08-14 Remove redundant trace spottted by Newbury
    [GP22_board-B.Cu.gbl, GP22_board-B.Mask.gbs, GP22_board-B.Paste.gbp, GP22_board-B.SilkS.gbo, GP22_board-Edge.Cuts.gm1, GP22_board-F.Cu.gtl, GP22_board-F.Mask.gts, GP22_board-F.Paste.gtp]
2018-09-10 Print schematic
    [BPSubsheet.sch, Counter.sch, DIYino.sch, GP22_Power.sch, GP22_board.sch, InputCoupling.sch]
2018-09-20 Get final cap values for BOM order with PCBTrain
    [BOM_seanD_order.xlsx, GP22_board.kicad_pcb, GP22_board.sch, InputCoupling.sch]
2018-09-26 Correct BOM issues in schematic + update to Kicad v5.0
    [BPSubsheet-2018-09-26-16-41-27.sch, Counter-2018-09-26-16-41-27.sch, DIYino-2018-09-26-16-41-27.sch, GP22_Power-2018-09-26-16-41-27.sch, GP22_board-2018-09-26-16-41-27.sch, InputCoupling-2018-09-26-16-41-27.sch]
2018-09-26 Update board to Kicad v5 (no changes yet)
    [GP22_board.kicad_pcb]
2018-10-05 Correct logic bug in calibration routine and remove unused (and impossible) method
    [TDC_Arduino_Driver.ino]
2019-10-08 Defaults for measure()
    [BOM.xlsx, GP22_Panel.SLDPRT, GP22_Panel_HP12.SLDPRT, GP22_Panel_HP12.STL]
2019-10-08 Add Labview drivers for new functions, and NTP sync function
2019-10-09 Correctly configure fire pulses
    [GP22_reg.h, TDC_Arduino_Driver.ino]
2019-10-11 Add 14HP panel
    [GP22_Panel_HP14.SLDPRT, GP22_Panel_HP14.STL]
2019-10-11 Fix 14hp panel
    [GP22_Panel.SLDPRT, GP22_Panel.STL, GP22_Panel_HP12.SLDPRT, GP22_Panel_HP12.STL, GP22_Panel_HP14.SLDPRT, GP22_Panel_HP14.STL]
2019-10-17 Rack mount for 12HP
    [GP22_Panel_HP12.STL, GP22_Panel_HP14.SLDPRT, GP22_Panel_HP14.STL]
